JD-edu/ros2_book/rosbook_ws/src/jdcobot100_compressed.jpg

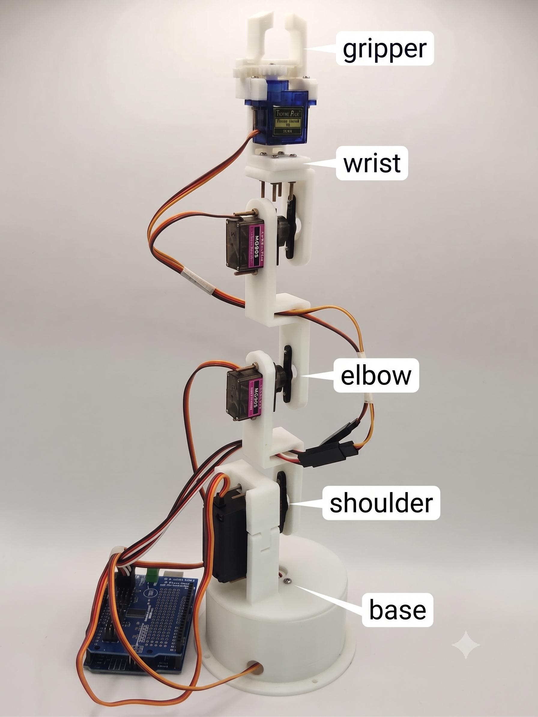
rosbook_ws/src/jdcobot100_compressed.jpg
