JD-edu/ros2_book/a_axis_robot_arm_documents/assembly.md

## jdCobot100 조립하기  
jdCobot100를 조립하기 전에 박스 안에 포함 되어 있는 키트구성품을 확인합니다. 구매하신 jdCobot100 키트 안에는 다음 사진과 같은 키트 구성품이 있습니다. 

jdCobot100전체 부품 사진 

키트의 박스 안에는 키트 패킹 리스트가 있습니다. 키트 패킹 리스트와 실제 구성품이 일치하는지 확인합니다. 
**OS SD카드, 아두이노 보드는 포함되어 있지 않습니다. 별도 구매하셔야 합니다. 

### 조립주의사항: 3D 프린팅 부품은 프린팅 과정에서 지지대나 필라멘트 잔여물이 있습니다. 이런 것은 제거해 주시고, 나사 등 구멍의 직경이 좁을 경우 드릴 등으로 다음어 주셔야 합니다.  

### 1. 베이스 모듈 조립   
패킹 리스트를 통해서 구성품을 확인했으면 그 다음에는 베이스 모듈을 조립합니다. 베이스 모듈은 다음 부품이 필요합니다.  

- 베이스 원통
- 베이스 서보홀더 
- MG90 서보모터
- M2x20 볼트 2개, M2 너트 2개 
- 조립을 위한 드라이버 렌치

1_베이스_1
2_베이스_2

먼저 베이스 서보홀더와 MG90을 결합합니다. 

3_베이스_3
4_베이스_4

그 다움에 베이스 서보홀더 어셈블리를 베이스원통에 결합합니다. 

### 2. 숄더 모듈의 조립 
베이스 모듈위애 올라가는 숄더 모듈을 조립합니다. 숄도 모듈 조립에는 다음과 같은 부품이 필요합니다.

- 숄더 모듈
- MG996R서보 
- M2x20 볼트 2개
- M2 너트 2개
  
5_어깨_1

베이스 모듈과 숄더 모듈을 조립하기 위해서 MG90 서보의 서보혼을 이용합니다. MP90 서보 패키지 안에는 여러 종류의 서보혼과 서보혼용 나사가 있습니다. 
이것을 활용하여 다음과 같이 숄더 모듈에 서보혼을 고정합니다. 

6_어깨_2

다음에는 숄더 모듈에 M2x20 볼트와 너트를 사용하여 MG996R 서보모터를 고정합니다. MG996R 서보모터를 고정나사 부문이 직경이 M2x20 나사를 넣기에는 큽니다.
따라서 MG996R에 내장된 금속캡과 고무패킹을 사용하셔야 합니다. 

7_어깨_3

### 3. 암 모듈의 조립 
숄더 모듈을 조립한 후, 암 모듈을 조립합니다. 로봇암의 특성상 베이스 모듈, 숄더 모듈, 암 모듈을 조립한 후 영점을 잡고 최종 조립을 해야 합니다. 
영점을 잡기전에는 베이스 모듈, 숄더 모듈, 암 모듈을 조립하지 마십시오.  암 모듈은 다음 부품이 필요합니다. 

- MG90 서보 2개
- MG90 서보혼 2
- MG996R 서보혼 1 
- 서보혼 고정 나사 6개  
- M2x20 볼트 4, 너트 4 

8_팔_1

주의 해야할 것은 숄더 모듈과 연결되는 암은 다른 2개의 암과 달리 MG996R 서보혼을 사용합니다. 다른 두개의 암은 MG90의 서보혼을 사용하여 조립합니다. 
졸비은 모두 M2x20 볼트와 M2 너트를 사용하여 조립합니다. 

9_팔_2

### 4. 그리퍼 조립 
암 모듈 조립후에는 그리퍼 모듈을 조립합니다. 그리퍼는 작고 여러개의 부품으로 되어 있으몰 주의가 필요합니다. 그리퍼 조립은 다음 부품이 필요합니다. 

11_그리퍼_1

- 그리퍼 본체
- 기어
- 리니어 기어
- 그리퍼 암
- SG90 서보 및 서보 혼
- M2x20 볼트 M2 너트 각 2개 

12_그리퍼_2

13_그리퍼_3

그리퍼를 최종 조립하면 다음과 같이 조립이 됩니다. 그리퍼는 암3에 M2x20 볼트와 M2너트를 사용하여 결합합니다. 
15_그리퍼_5

### 5. 최종조립   
베이스 모듈, 숄더 모듈, 암 모듈, 그리퍼 모듈이 조립이 되면 영접을 잡은 후에 최종 조립을 하게 됩니다.

16_최종_1

영점을 맞추기 위해서는 먼저 아래 그림과 같이 로봇암 각 모듈과 컨트롤러를 배선합니다. 
이후에 아두이노 코드 중에서 100_servo_center.ino 파일을 아두이노에 프로그래밍을 하면 각 모듈의 서보모터가 영점을 잡습니다. 

그러면 다음과 같이 로봇암을 최종 조립합니다. 최종 조립을 할때는 로봇암이 지면에서 수직으로 일차형이 되도록 조립합니다. 
조립된 로봇암을 동작시키는 모습은 다음과 같습니다. 

17_최종_2
