JD-edu/ros2_book/frizing_circuit/ch15/ch15_2wheel_robot_circuit_bb.png

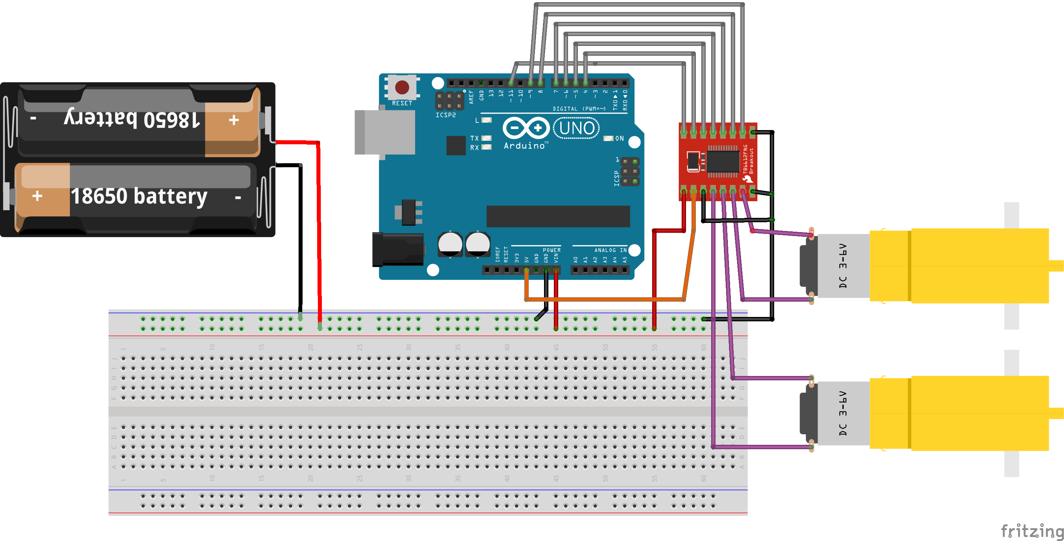
frizing_circuit/ch15/ch15_2wheel_robot_circuit_bb.png
