JD-edu/ros2_book/frizing_circuit/ch16/ch16_enoder_2wheel_robot.png

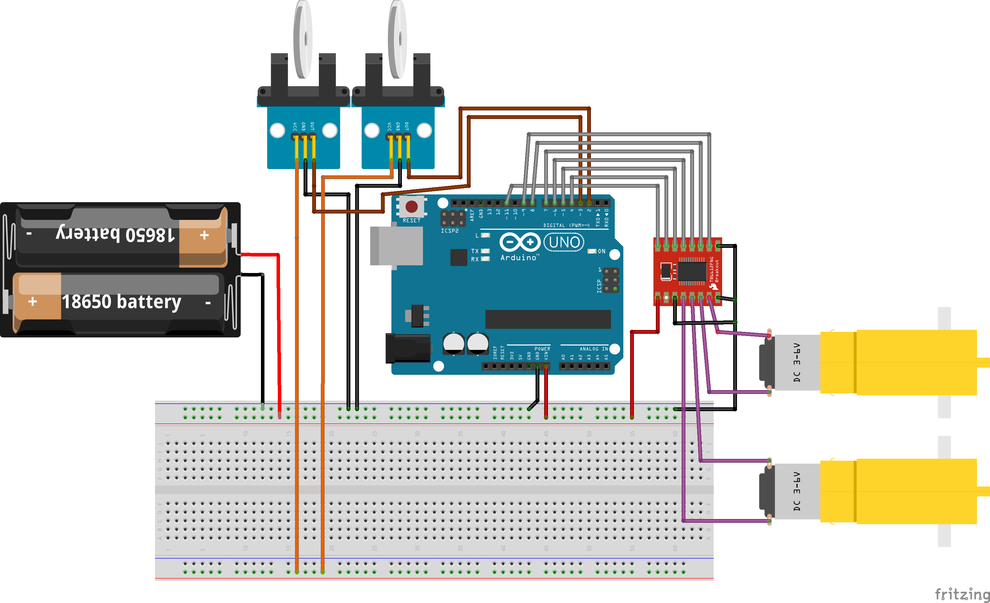
frizing_circuit/ch16/ch16_enoder_2wheel_robot.png
