JD-edu/ros2_book/frizing_circuit/ch18/ch18_4axis_robot_arm.png

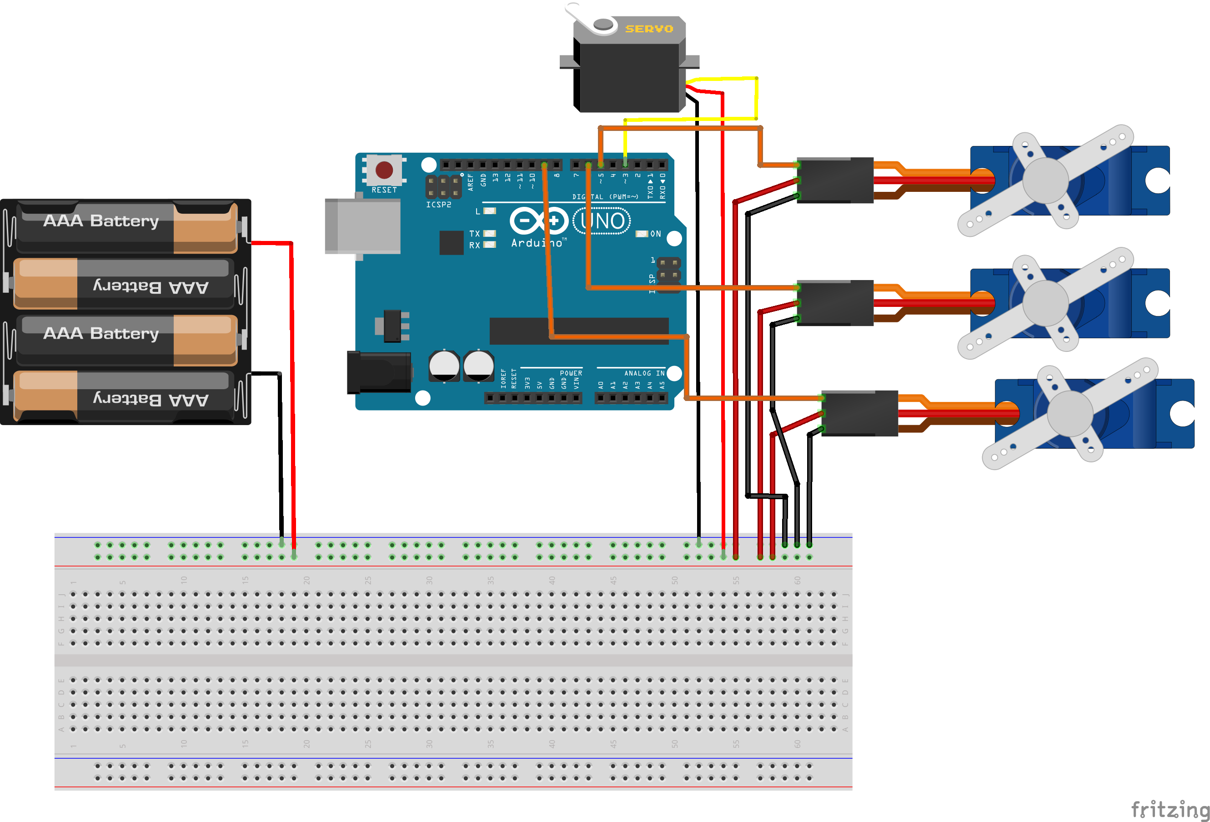
frizing_circuit/ch18/ch18_4axis_robot_arm.png
