JD-edu/ros2_book/3D_printing_laser_cutting/2wheel_robot_body_laser_cutting/jdAMR100_motor_mount.dxf

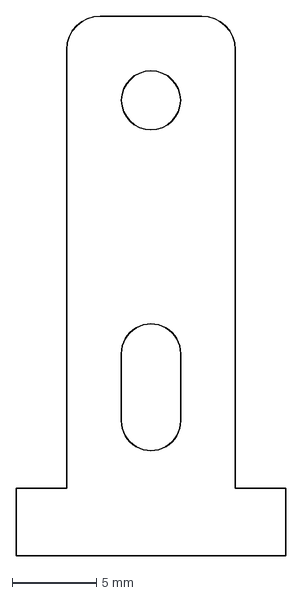
[picture p5: CAD file, 2026-09-06]
3D_printing_laser_cutting/2wheel_robot_body_laser_cutting/jdAMR100_motor_mount.dxf
16.0 x 32.0 mm
