JD-edu/ros2_book/3D_printing_laser_cutting/4axis_robot_arm/base_part_2.stl

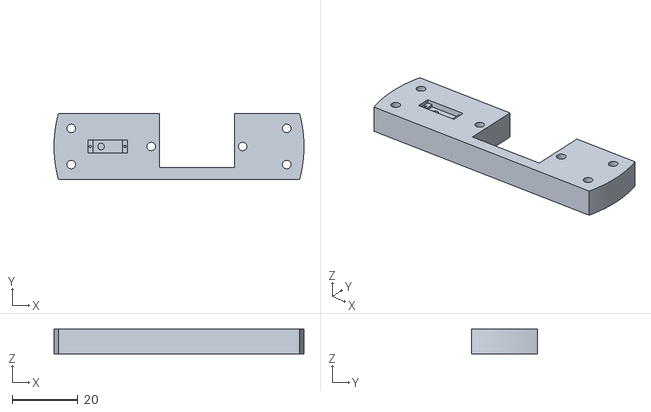
[picture p6: CAD file, 2026-09-24]
3D_printing_laser_cutting/4axis_robot_arm/base_part_2.stl
76.0 x 20.0 x 7.50
