JD-edu/ros2_book/rosbook_ws/src/ch18_22_robot_arm/meshes/shoulder_big_part_1.stl

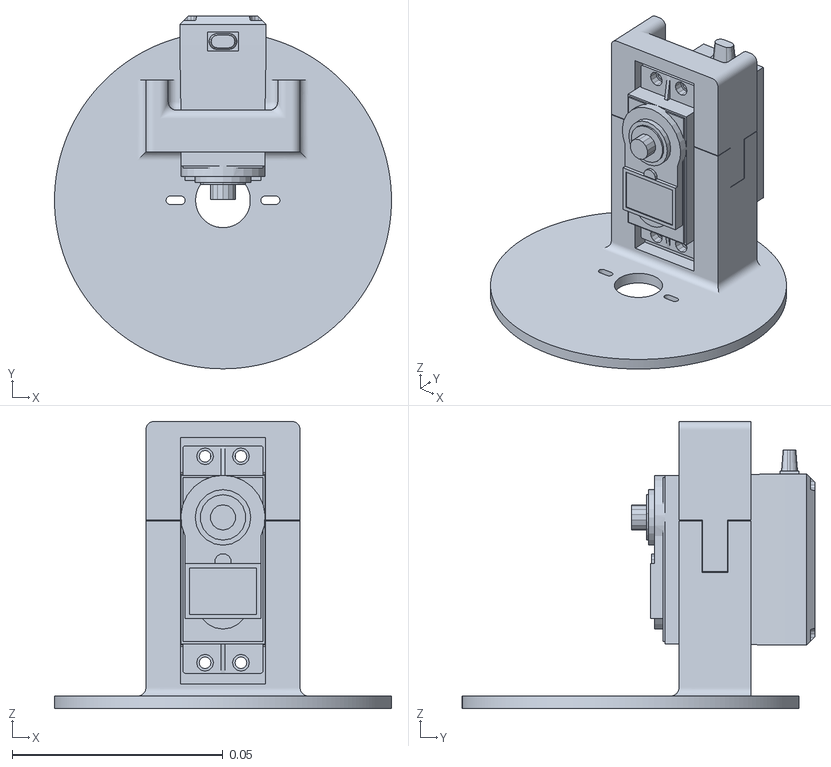
[picture p7: CAD file, 2026-09-24]
rosbook_ws/src/ch18_22_robot_arm/meshes/shoulder_big_part_1.stl
0.08 x 0.0837 x 0.0682
