JD-edu/ros2_book/3D_printing_laser_cutting/2wheel_robot_body_laser_cutting/jdAMR100_top.dxf

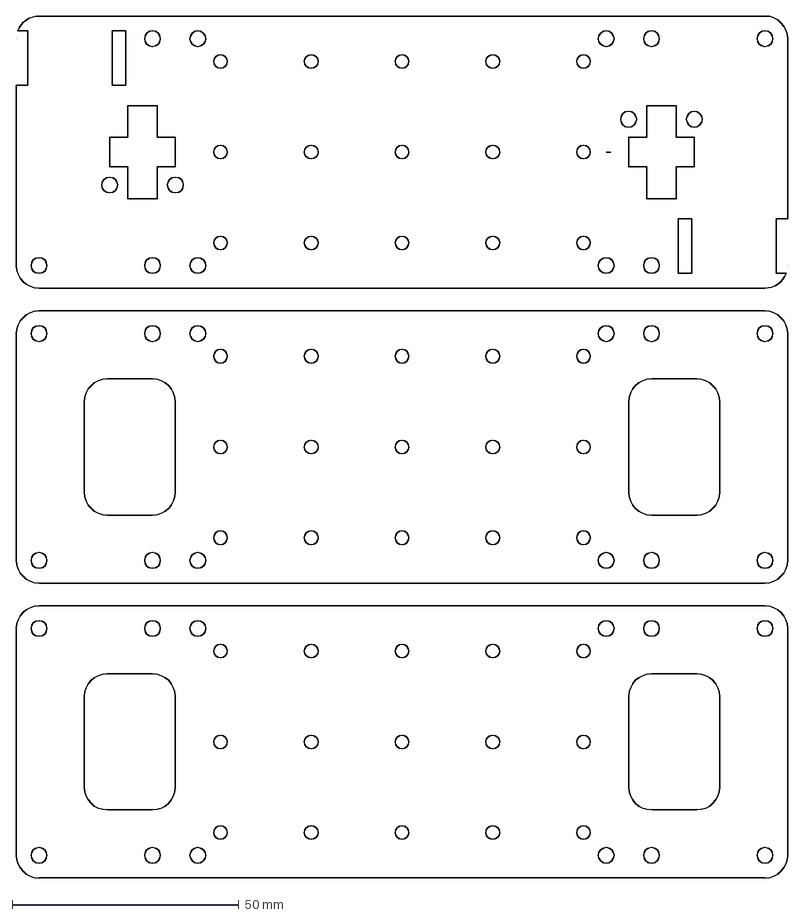
[picture p8: CAD file, 2026-09-06]
3D_printing_laser_cutting/2wheel_robot_body_laser_cutting/jdAMR100_top.dxf
170.0 x 190.0 mm
