JD-edu/ros2_book/3D_printing_laser_cutting/4axis_robot_arm/arm_3.stl

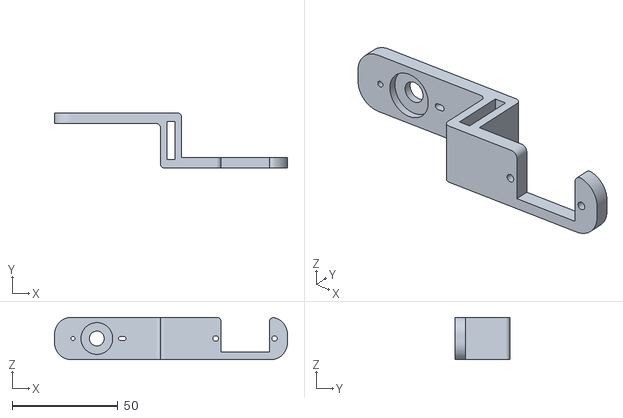
[picture p9: CAD file, 2026-09-24]
3D_printing_laser_cutting/4axis_robot_arm/arm_3.stl
110.0 x 26.0 x 20.0
