JD-edu/ros2_book/rosbook_ws/src/ch18_22_robot_arm/meshes/Round_gear.stl

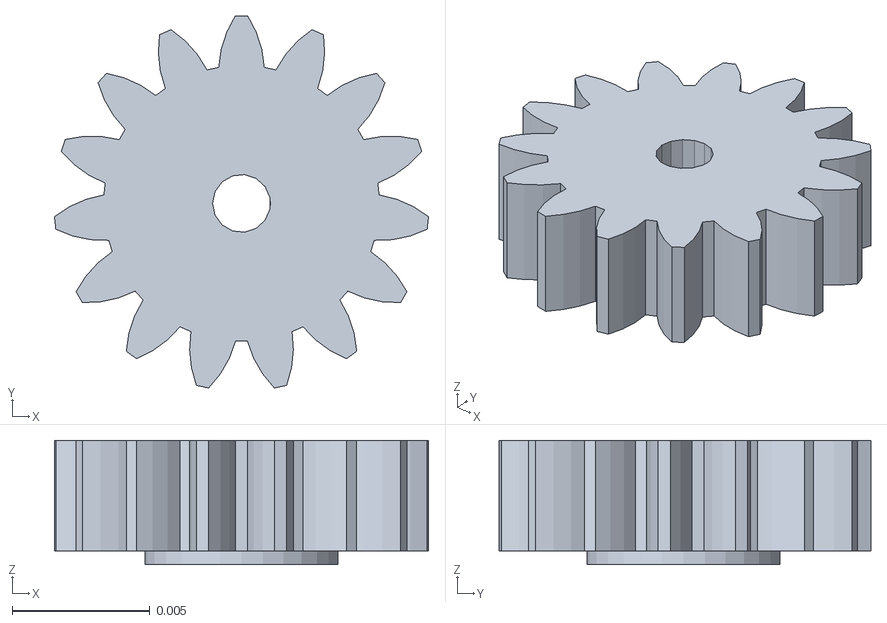
[picture p10: CAD file, 2026-09-24]
rosbook_ws/src/ch18_22_robot_arm/meshes/Round_gear.stl
0.0136 x 0.0135 x 0.0045
