JD-edu/ros2_book/3D_printing_laser_cutting/2wheel_robot_body_laser_cutting/jdAMR100_bottom.dxf

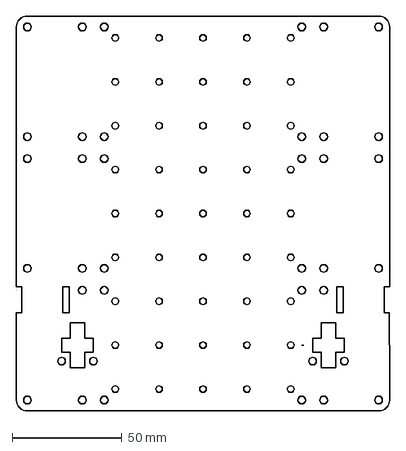
[picture p11: CAD file, 2026-09-06]
3D_printing_laser_cutting/2wheel_robot_body_laser_cutting/jdAMR100_bottom.dxf
170.0 x 180.0 mm
