JD-edu/ros2_book/3D_printing_laser_cutting/4axis_robot_arm/base_part_1.stl

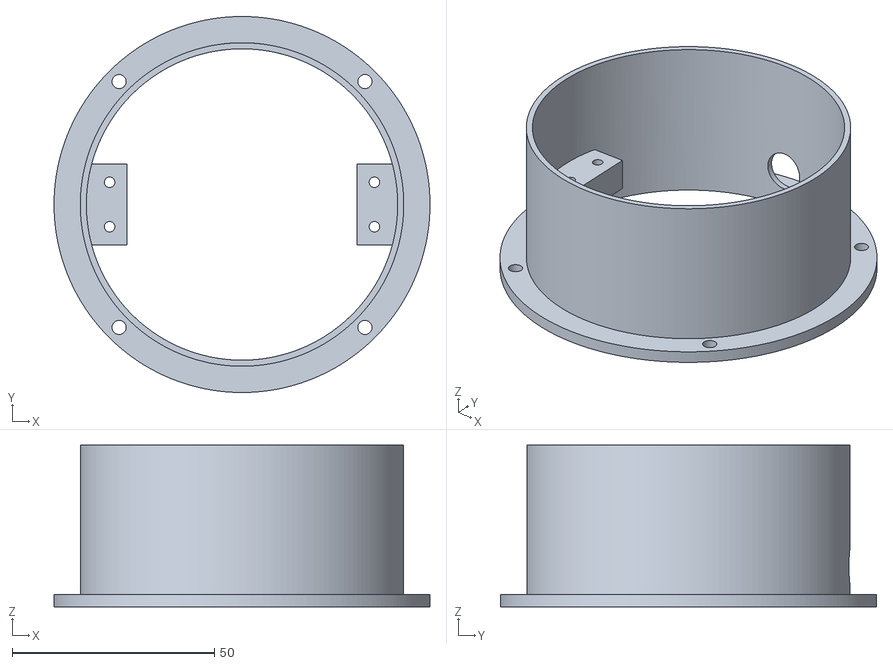
[picture p12: CAD file, 2026-09-24]
3D_printing_laser_cutting/4axis_robot_arm/base_part_1.stl
93.0 x 93.0 x 40.0
