JD-edu/ros2_book/rosbook_ws/src/ch18_22_robot_arm/meshes/base.stl

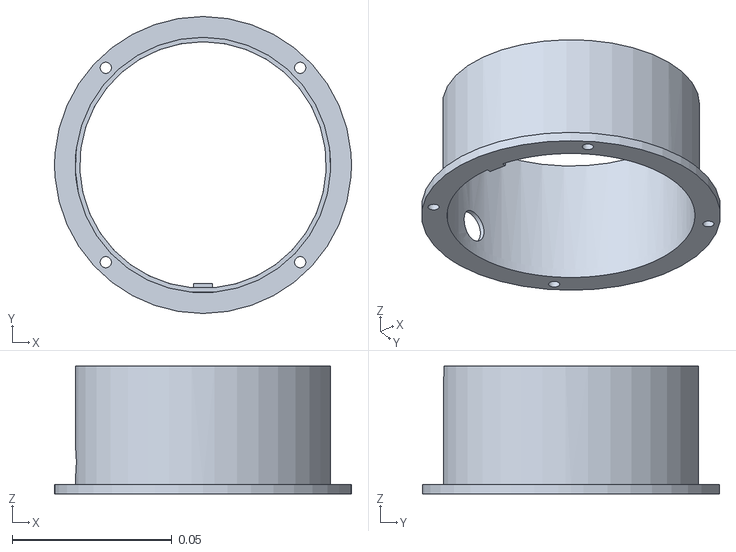
[picture p13: CAD file, 2026-09-24]
rosbook_ws/src/ch18_22_robot_arm/meshes/base.stl
0.0929 x 0.0929 x 0.04
