JD-edu/ros2_book/3D_printing_laser_cutting/4axis_robot_arm/shoulder_big_part_1.stl

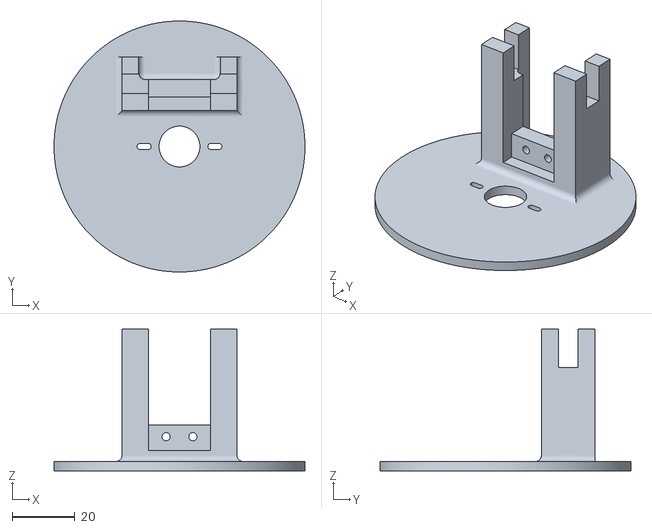
[picture p14: CAD file, 2026-09-24]
3D_printing_laser_cutting/4axis_robot_arm/shoulder_big_part_1.stl
80.0 x 80.0 x 45.2
