JD-edu/ros2_book/rosbook_ws/src/ch18_22_robot_arm/meshes/gripper_finger.stl

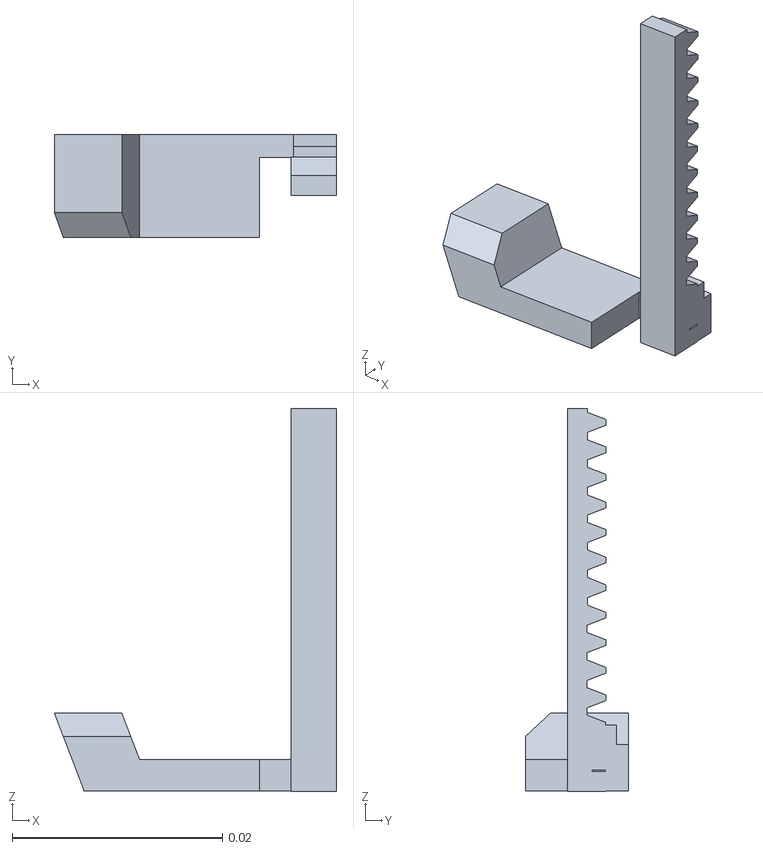
[picture p15: CAD file, 2026-09-24]
rosbook_ws/src/ch18_22_robot_arm/meshes/gripper_finger.stl
0.0269 x 0.00981 x 0.0365
