JD-edu/ros2_book/3D_printing_laser_cutting/4axis_robot_arm/gripper_base.stl

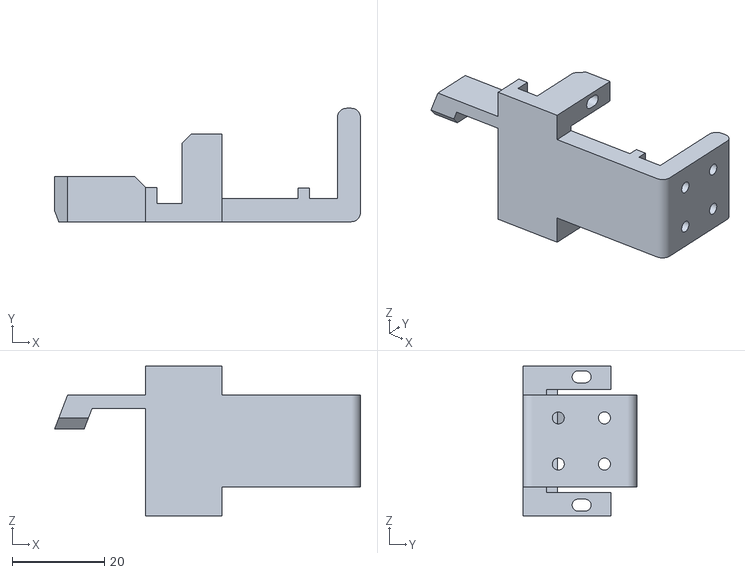
[picture p16: CAD file, 2026-09-24]
3D_printing_laser_cutting/4axis_robot_arm/gripper_base.stl
66.3 x 24.6 x 32.4
