JD-edu/ros2_book/rosbook_ws/src/ch18_22_robot_arm/meshes/shoulder_big_part_2.stl

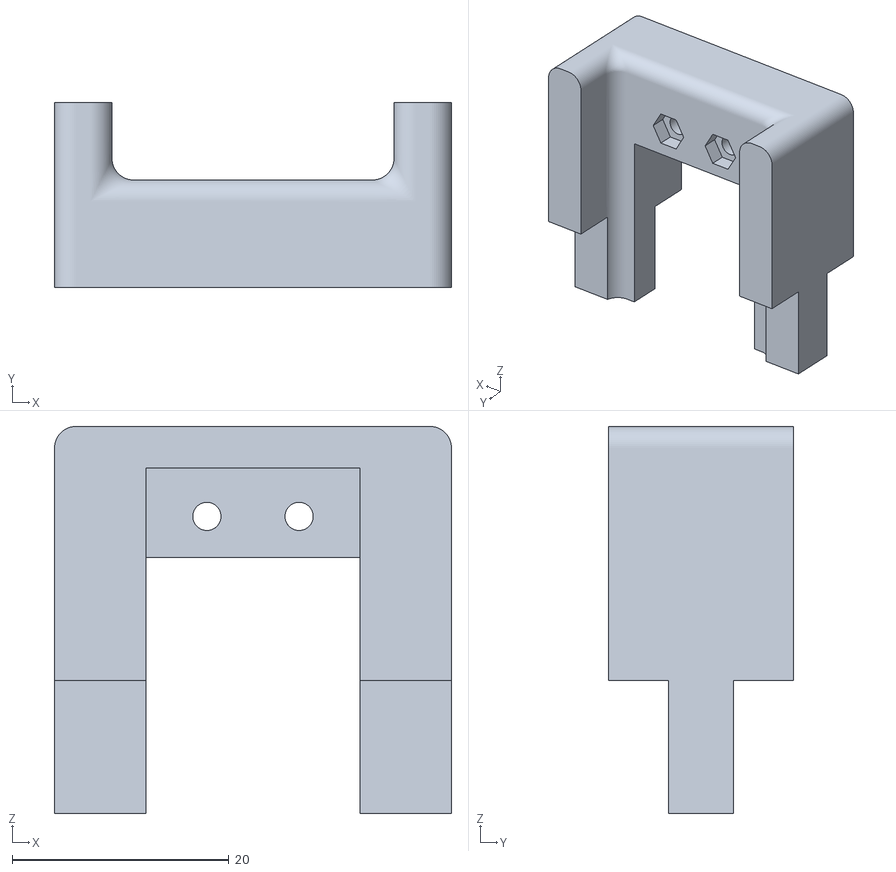
[picture p17: CAD file, 2026-09-08]
rosbook_ws/src/ch18_22_robot_arm/meshes/shoulder_big_part_2.stl
36.6 x 17.1 x 35.7
