JD-edu/ros2_book/3D_printing_laser_cutting/4axis_robot_arm/Linear_gear.stl

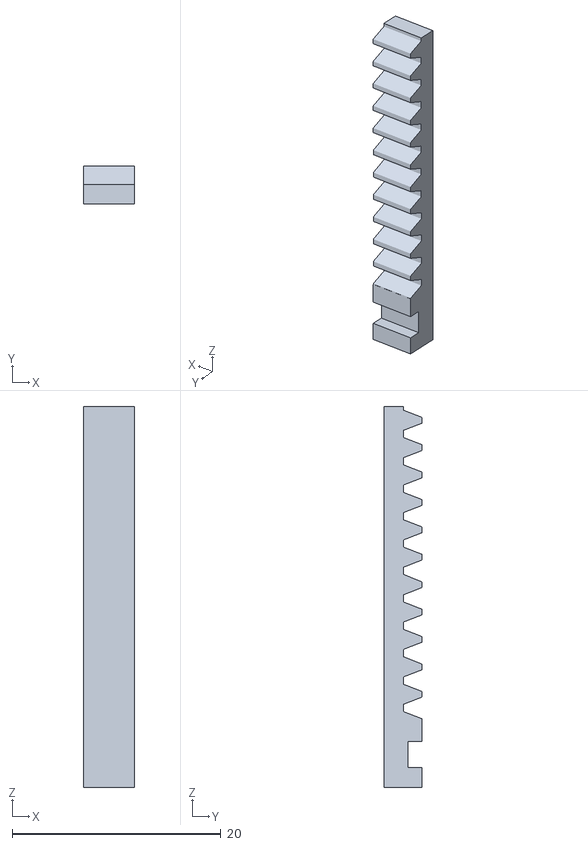
[picture p18: CAD file, 2026-09-24]
3D_printing_laser_cutting/4axis_robot_arm/Linear_gear.stl
4.84 x 3.68 x 36.5
