JD-edu/ros2_book/3D_printing_laser_cutting/4axis_robot_arm/Round_gear.stl

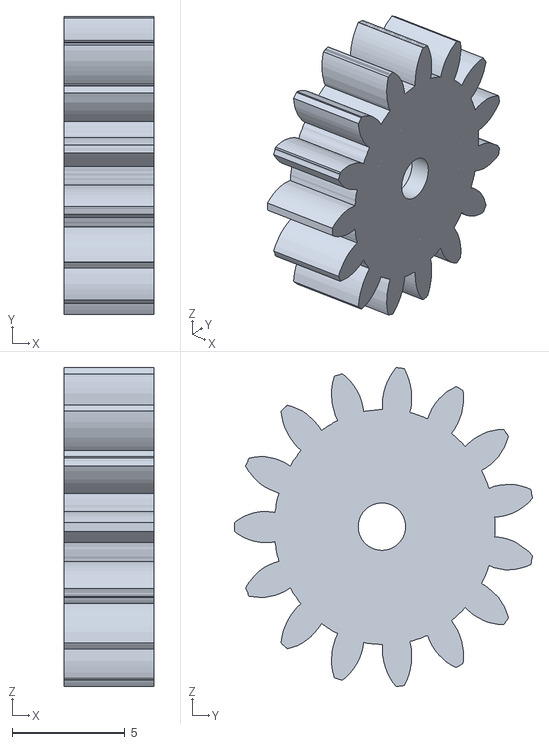
[picture p19: CAD file, 2026-09-24]
3D_printing_laser_cutting/4axis_robot_arm/Round_gear.stl
4.00 x 13.2 x 14.2
