JD-edu/ros2_book/3D_printing_laser_cutting/4axis_robot_arm/arm_1.stl

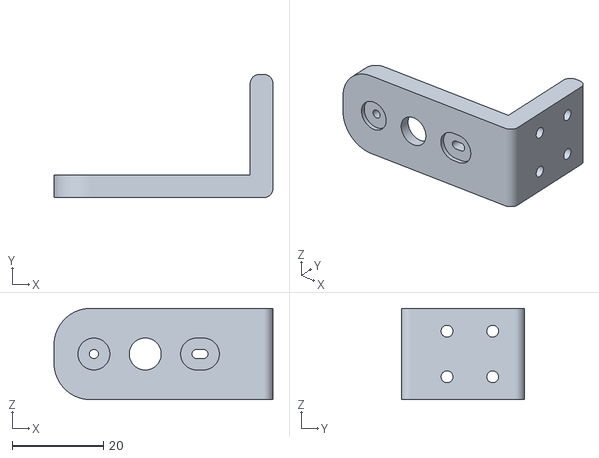
[picture p20: CAD file, 2026-09-24]
3D_printing_laser_cutting/4axis_robot_arm/arm_1.stl
48.0 x 27.0 x 20.0
