JD-edu/ros2_book/3D_printing_laser_cutting/4axis_robot_arm/gripper_finger.stl

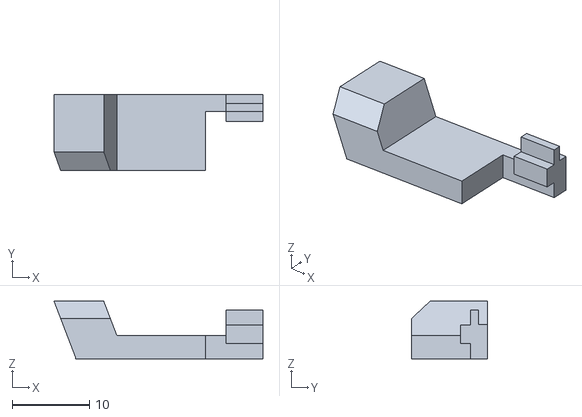
[picture p21: CAD file, 2026-09-08]
3D_printing_laser_cutting/4axis_robot_arm/gripper_finger.stl
27.0 x 9.81 x 7.43
