JD-edu/ros2_book/rosbook_ws/src/ch13_mobile_robot/urdf/ch13_mobile_robot.urdf

<?xml version="1.0"?>
<robot name="ch13_mobile_robot">
  <material name="chassis_color">
    <color rgba="0.2 0.4 0.8 1.0"/>
  </material>
  <material name="wheel_color">
    <color rgba="0.1 0.1 0.1 1.0"/>
  </material>
  <material name="caster_color">
    <color rgba="0.6 0.6 0.6 1.0"/>
  </material>

  <link name="base_link">
    <visual>
      <origin xyz="0 0 0.05" rpy="0 0 0"/>
      <geometry>
        <box size="0.3 0.2 0.1"/>
      </geometry>
      <material name="chassis_color"/>
    </visual>
  </link>

  <link name="left_wheel_link">
    <visual>
      <origin xyz="0 0 0" rpy="1.570796 0 0"/>
      <geometry>
        <cylinder radius="0.05" length="0.04"/>
      </geometry>
      <material name="wheel_color"/>
    </visual>
  </link>

  <joint name="left_wheel_joint" type="continuous">
    <parent link="base_link"/>
    <child link="left_wheel_link"/>
    <origin xyz="0 0.12 0" rpy="0 0 0"/>
    <axis xyz="0 1 0"/>
  </joint>

  <link name="right_wheel_link">
    <visual>
      <origin xyz="0 0 0" rpy="1.570796 0 0"/>
      <geometry>
        <cylinder radius="0.05" length="0.04"/>
      </geometry>
      <material name="wheel_color"/>
    </visual>
  </link>

  <joint name="right_wheel_joint" type="continuous">
    <parent link="base_link"/>
    <child link="right_wheel_link"/>
    <origin xyz="0 -0.12 0" rpy="0 0 0"/>
    <axis xyz="0 1 0"/>
  </joint>

  <link name="caster_link">
    <visual>
      <geometry>
        <sphere radius="0.025"/>
      </geometry>
      <material name="caster_color"/>
    </visual>
  </link>

  <joint name="caster_joint" type="fixed">
    <parent link="base_link"/>
    <child link="caster_link"/>
    <origin xyz="0.1 0 -0.025" rpy="0 0 0"/>
  </joint>
</robot>
