JD-edu/ros2_book/(list of files, drawings)

Other design files:
frizing_circuit/ch15/ch15_2wheel_robot_circuit.fzz
frizing_circuit/ch15/ch15_2wheel_robot_circuit_l298p.fzz
frizing_circuit/ch16/ch16_enoder_2wheel_robot.fzz
frizing_circuit/ch17/ch15_2wheel_robot_circuit_l298p_encoder.fzz
frizing_circuit/ch18/ch18_4axis_robot_arm.fzz
