JD-edu/ros2_book/rosbook_ws/src/ch17_mobile_robot/config/robot.yaml

motor_node:
  ros__parameters:
    wheel_radius: 0.033
    wheel_base: 0.160
    max_rpm: 120.0
    command_timeout: 0.5

encoder_node:
  ros__parameters:
    serial_port: "/dev/ttyACM0"
    baudrate: 115200

odom_node:
  ros__parameters:
    wheel_radius: 0.033
    wheel_base: 0.160
    ticks_per_rev: 60
