JD-edu/ros2_book/(commit log)

2026-09-06 add laser cut component
    [ch14_2wheel_robot_circuit.fzz, jdAMR100_bottom.dxf, jdAMR100_motor_mount.dxf, jdAMR100_top.dxf]
2026-09-08 Sep 8th
    [Linear_gear.stl, Round_gear.stl, arm_1.stl, arm_2.stl, arm_3.stl, base.stl, ch14_2wheel_robot_circuit.fzz, ch15_2wheel_robot_circuit.fzz]
2026-09-24 add robot arm code
    [base_link.STL, ch15_2wheel_robot_circuit_l298p.fzz, ch15_2wheel_robot_circuit_l298p_encoder.fzz, link_1.STL, link_2.STL, link_3.STL, link_4.STL, link_5.STL]
2026-09-24 Modify STL name
    [Linear_gear.stl, Round_gear.stl, base.stl, elbow_wrist.stl, gripper_finger.stl, robot_arm.urdf, shoulder_big_part_1.stl, shoulder_big_part_2.stl]
2026-09-24 add robot arm assembly manual
    [Linear_gear.stl, Round_gear.stl, arm_1.stl, arm_2.stl, arm_3.stl, base.stl, base_part_1.stl, base_part_2.stl]
